bassistTech/pageTurningPedal/(commit log)

2024-02-24 added 2 button pedal
2024-12-26 Updated button logic in v2 program
